fleremiasflemin20-maker/muelle-carga-todo-en-uno/02_modelos_stl/MC-03_magsafe_airpods4_sin_reloj.stl

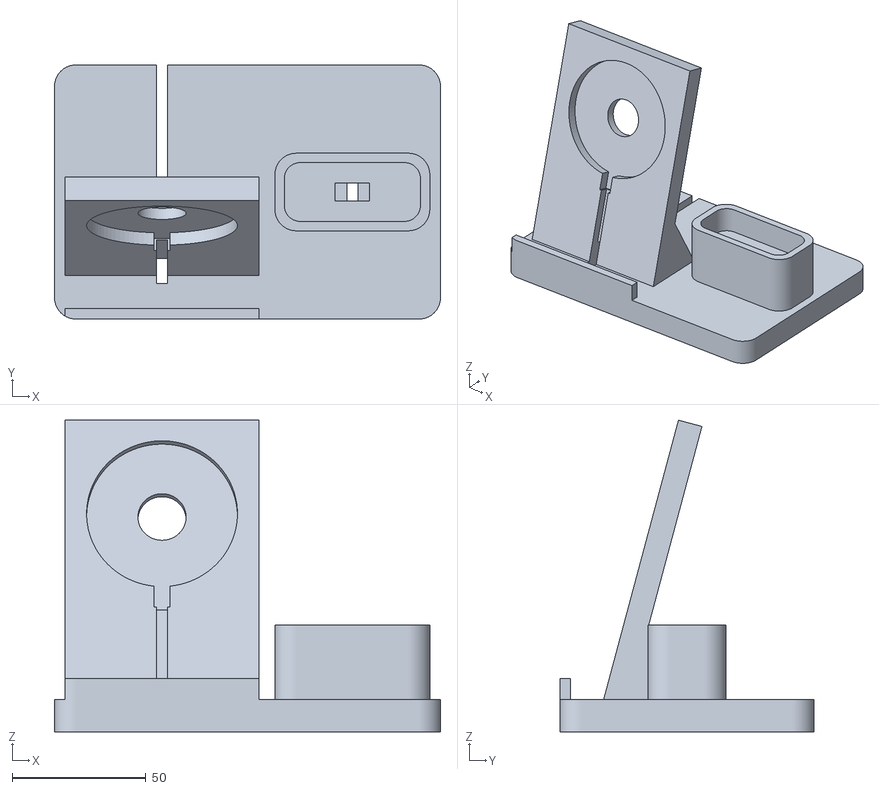
[picture p10: CAD file, 2026-10-10]
02_modelos_stl/MC-03_magsafe_airpods4_sin_reloj.stl
144.3 x 95.0 x 116.5
