fleremiasflemin20-maker/muelle-carga-todo-en-uno/02_modelos_stl/MC-04_personalizado_texto_color2.stl

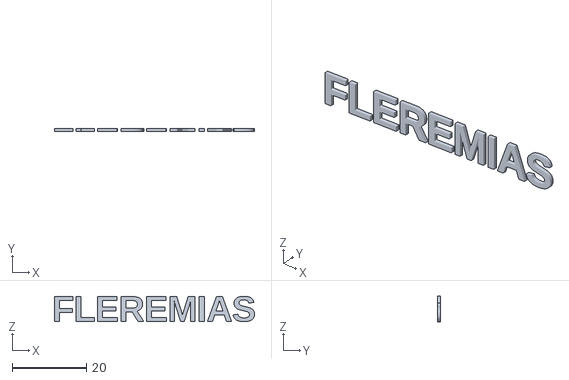
[picture p11: CAD file, 2026-10-10]
02_modelos_stl/MC-04_personalizado_texto_color2.stl
54.0 x 0.8 x 6.88
