fleremiasflemin20-maker/muelle-carga-todo-en-uno/02_modelos_stl/MC-04_personalizado_cuerpo.stl

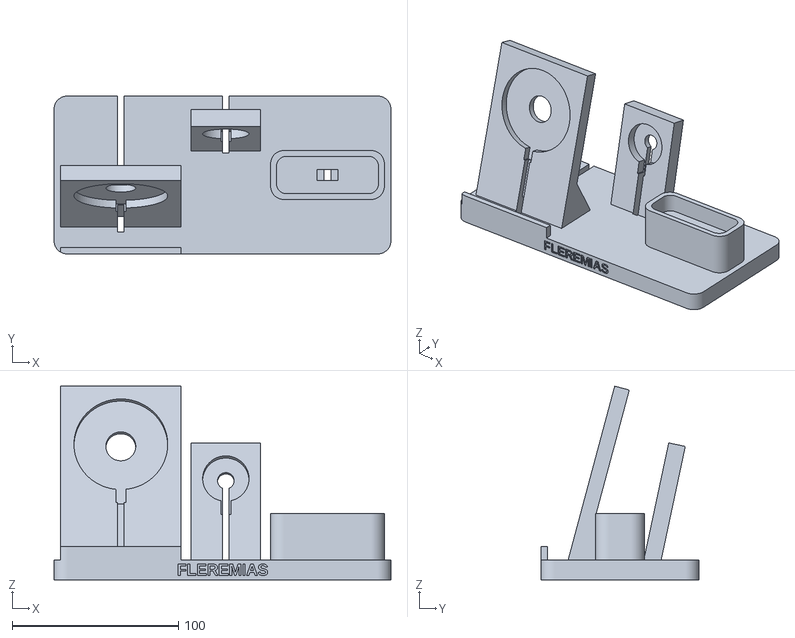
[picture p12: CAD file, 2026-10-10]
02_modelos_stl/MC-04_personalizado_cuerpo.stl
202.7 x 95.0 x 116.5
