fleremiasflemin20-maker/muelle-carga-todo-en-uno/02_modelos_stl/MC-00_prueba_de_ajuste.stl

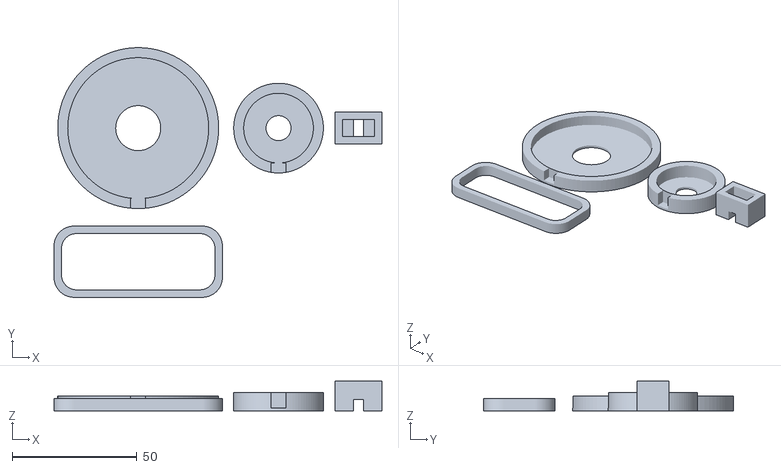
[picture p13: CAD file, 2026-10-10]
02_modelos_stl/MC-00_prueba_de_ajuste.stl
131.2 x 99.9 x 12.0
