fleremiasflemin20-maker/muelle-carga-todo-en-uno/02_modelos_stl/MC-02_usbc_applewatch_airpodspro2.stl

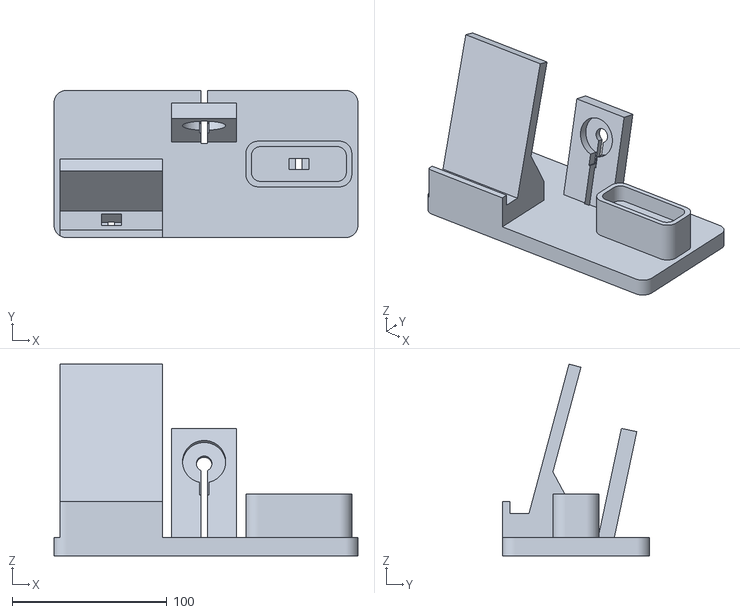
[picture p14: CAD file, 2026-10-10]
02_modelos_stl/MC-02_usbc_applewatch_airpodspro2.stl
196.3 x 95.0 x 123.9
