fleremiasflemin20-maker/muelle-carga-todo-en-uno/(list of files, cad)

Other CAD files:
02_modelos_stl/MC-01_magsafe_applewatch_airpodspro2.stl
