fleremiasflemin20-maker/muelle-carga-todo-en-uno/03_planos/PL_muelle_carga_planos_A3.pdf

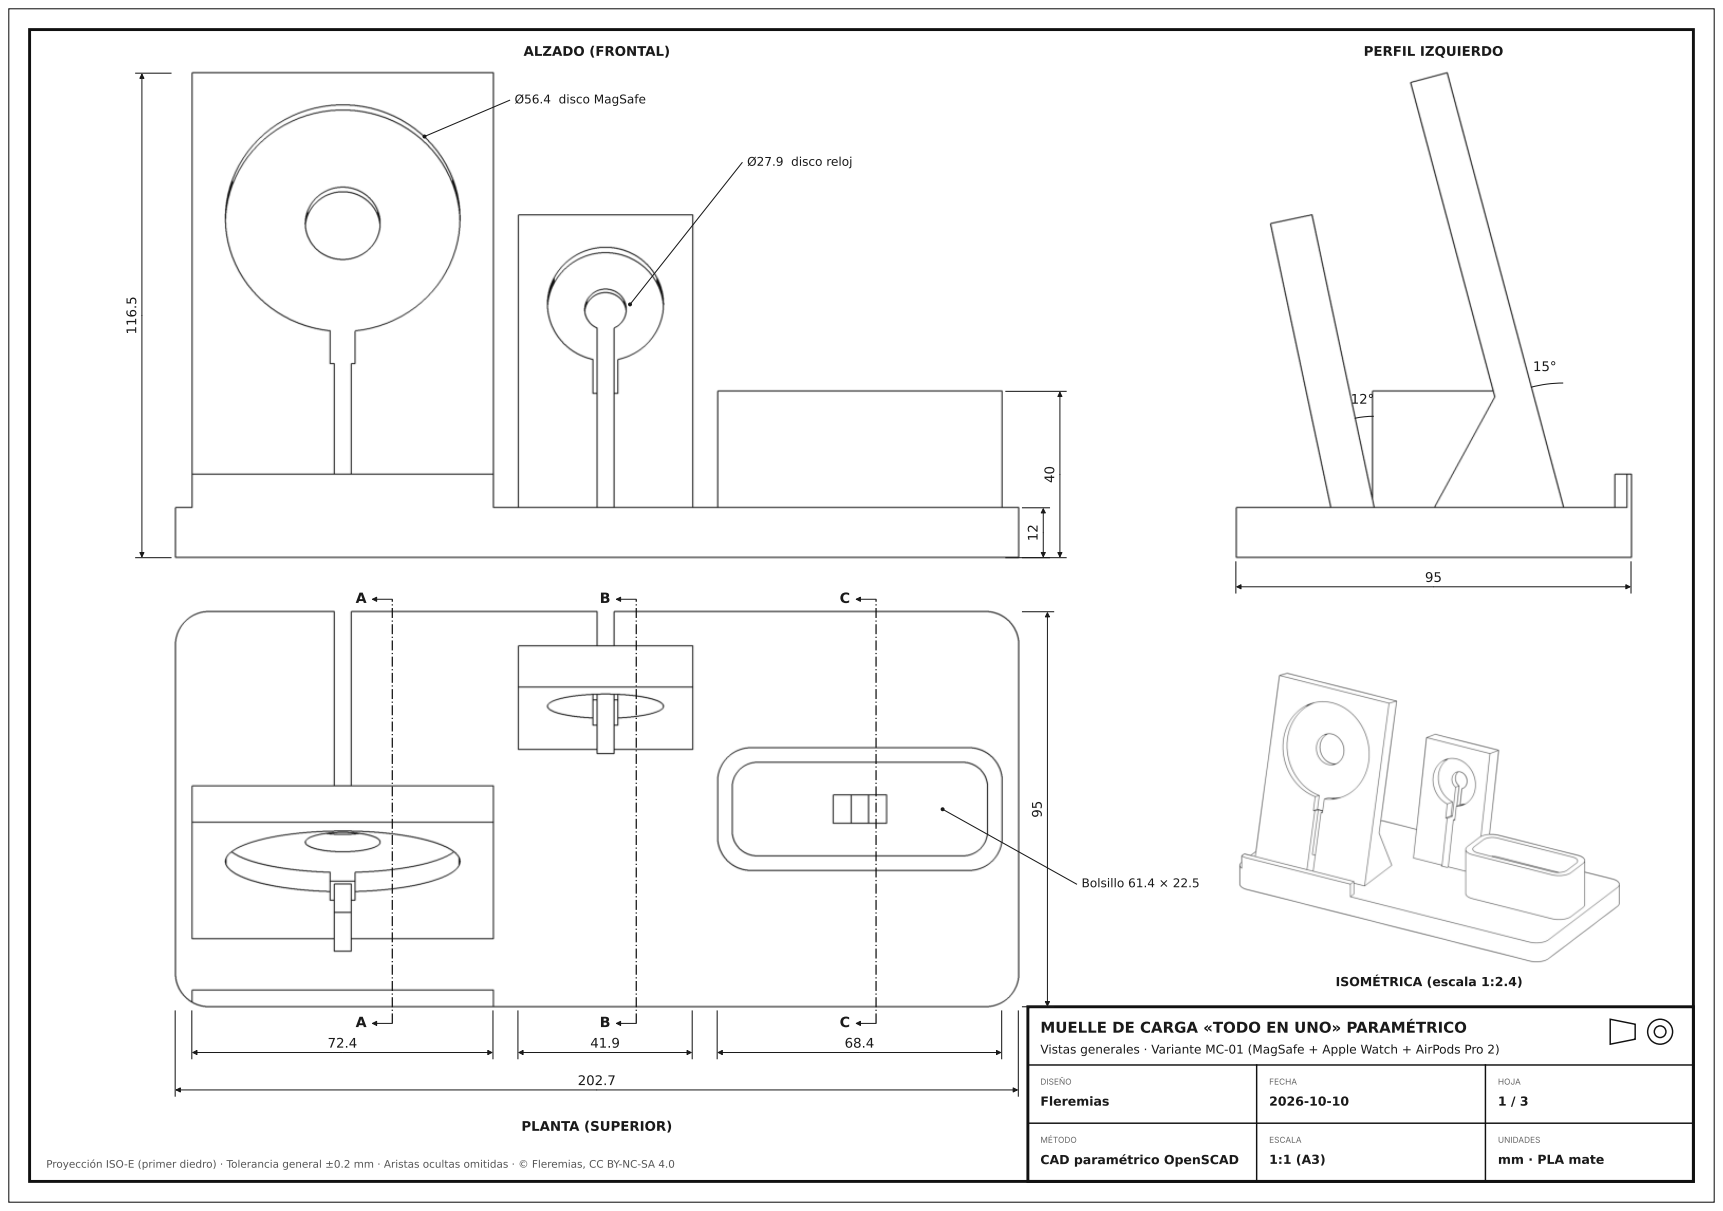
[picture p15: page 1]
DISEÑO; FECHA; HOJA; MÉTODO; ESCALA; UNIDADES; Fleremias; Proyección ISO-E (primer diedro) · Tolerancia general ±0.2 mm · Aristas ocultas omitidas · © Fleremias, CC BY-NC-SA 4.0; CAD paramétrico OpenSCAD; mm · PLA mate; ALZADO (FRONTAL); PLANTA (SUPERIOR); PERFIL IZQUIERDO; Ø56.4 disco MagSafe; Ø27.9 disco reloj; Bolsillo 61.4 × 22.5; ISOMÉTRICA (escala 1:2.4)

MUELLE DE CARGA «TODO EN UNO» PARAMÉTRICO

Vistas generales · Variante MC-01 (MagSafe + Apple Watch + AirPods Pro 2)

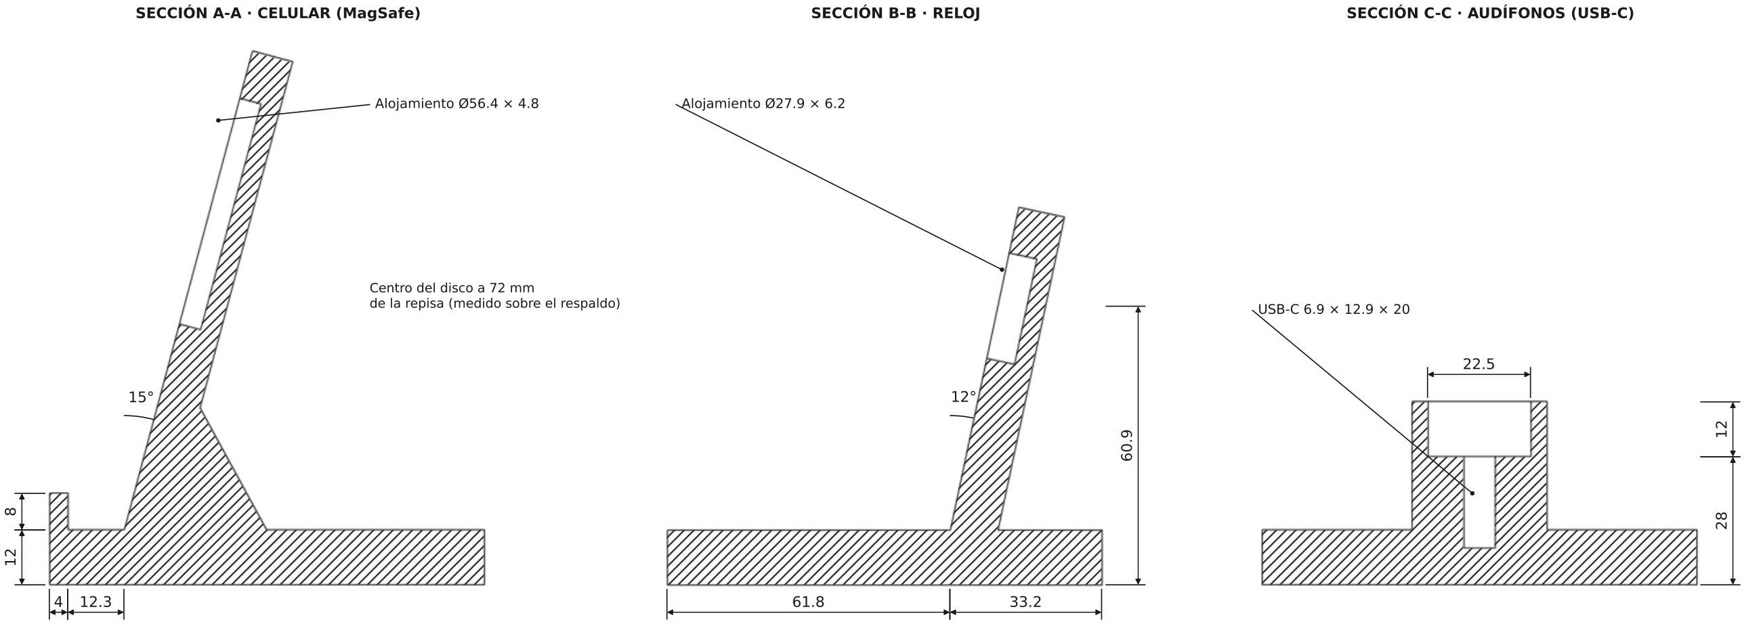
[picture p16: figure]
SECCIÓN A-A · CELULAR (MagSafe); Alojamiento Ø56.4 × 4.8; Centro del disco a 72 mm de la repisa (medido sobre el respaldo); SECCIÓN B-B · RELOJ; Alojamiento Ø27.9 × 6.2; SECCIÓN C-C · AUDÍFONOS (USB-C); USB-C 6.9 × 12.9 × 20
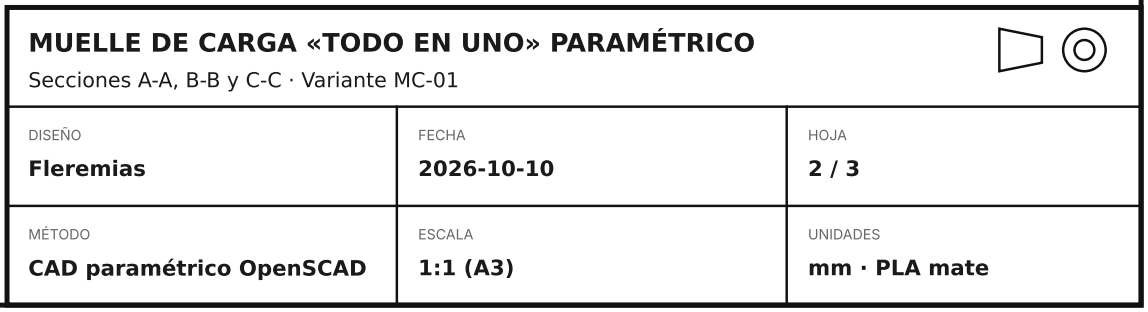
[picture p17: figure]
DISEÑO; FECHA; HOJA; Fleremias

### MUELLE DE CARGA «TODO EN UNO» PARAMÉTRICO

Secciones A-A, B-B y C-C · Variante MC-01

NOTAS

1. Medidas de alojamientos = medida nominal del cargador + holgura de 0.4 mm (parámetro «tolerancia»).
2. Los discos sobresalen 0.8 mm de su alojamiento para asegurar contacto magnético.
3. Todas las ranuras de cable son abiertas: el cable se inserta a presión sin pasar el conector.
4. Valores de la configuración por defecto; el archivo .scad recalcula todas las cotas.
5. Imprimir sin soportes, apoyado sobre la cara inferior. Puentes máximos ≤ 5 mm.
6. Los cortes van desplazados del eje de cada módulo; ranuras de cable y expulsores están en el eje (ver planta, hoja 1).

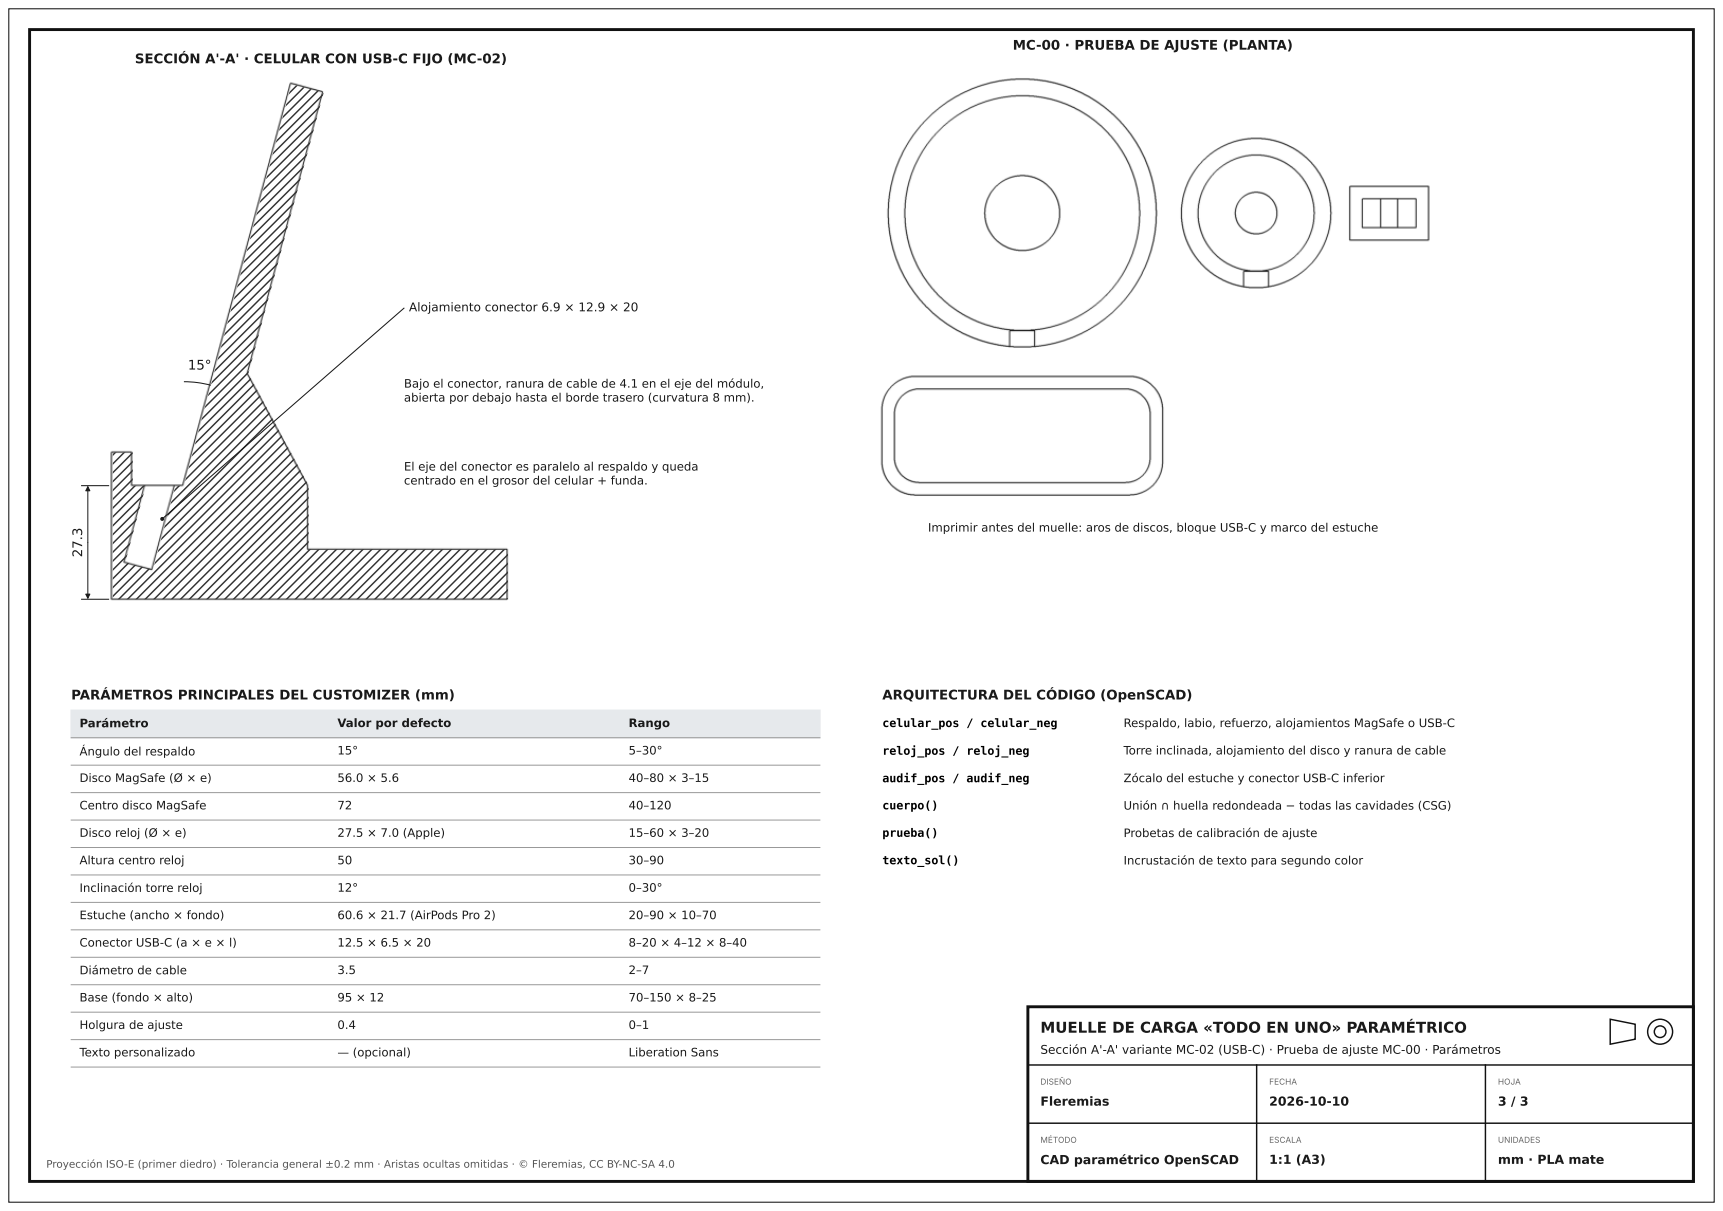
[picture p18: page 3]
DISEÑO; FECHA; HOJA; celular_pos / celular_neg; reloj_pos / reloj_neg; audif_pos / audif_neg; cuerpo(); prueba(); texto_sol(); Fleremias; Alojamiento conector 6.9 × 12.9 × 20; Parámetro; Valor por defecto; Rango; Ángulo del respaldo; Disco MagSafe (Ø × e); Centro disco MagSafe; Disco reloj (Ø × e); 27.5 × 7.0 (Apple); Altura centro reloj; Inclinación torre reloj; Estuche (ancho × fondo); 60.6 × 21.7 (AirPods Pro 2); Conector USB-C (a × e × l); Diámetro de cable; Base (fondo × alto)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

MC-00 · PRUEBA DE AJUSTE (PLANTA)

SECCIÓN A'-A' · CELULAR CON USB-C FIJO (MC-02)

Bajo el conector, ranura de cable de 4.1 en el eje del módulo,
abierta por debajo hasta el borde trasero (curvatura 8 mm).

El eje del conector es paralelo al respaldo y queda
centrado en el grosor del celular + funda.

Imprimir antes del muelle: aros de discos, bloque USB-C y marco del estuche

Respaldo, labio, refuerzo, alojamientos MagSafe o USB-C

Torre inclinada, alojamiento del disco y ranura de cable

Zócalo del estuche y conector USB-C inferior

Unión ∩ huella redondeada − todas las cavidades (CSG)

Probetas de calibración de ajuste

Incrustación de texto para segundo color

MUELLE DE CARGA «TODO EN UNO» PARAMÉTRICO

Sección A'-A' variante MC-02 (USB-C) · Prueba de ajuste MC-00 · Parámetros
